Da-Biggest-Seal/BOARD-mic/mic.kicad_pcb

## KiCad design mic.kicad_pcb (2026-08-21)

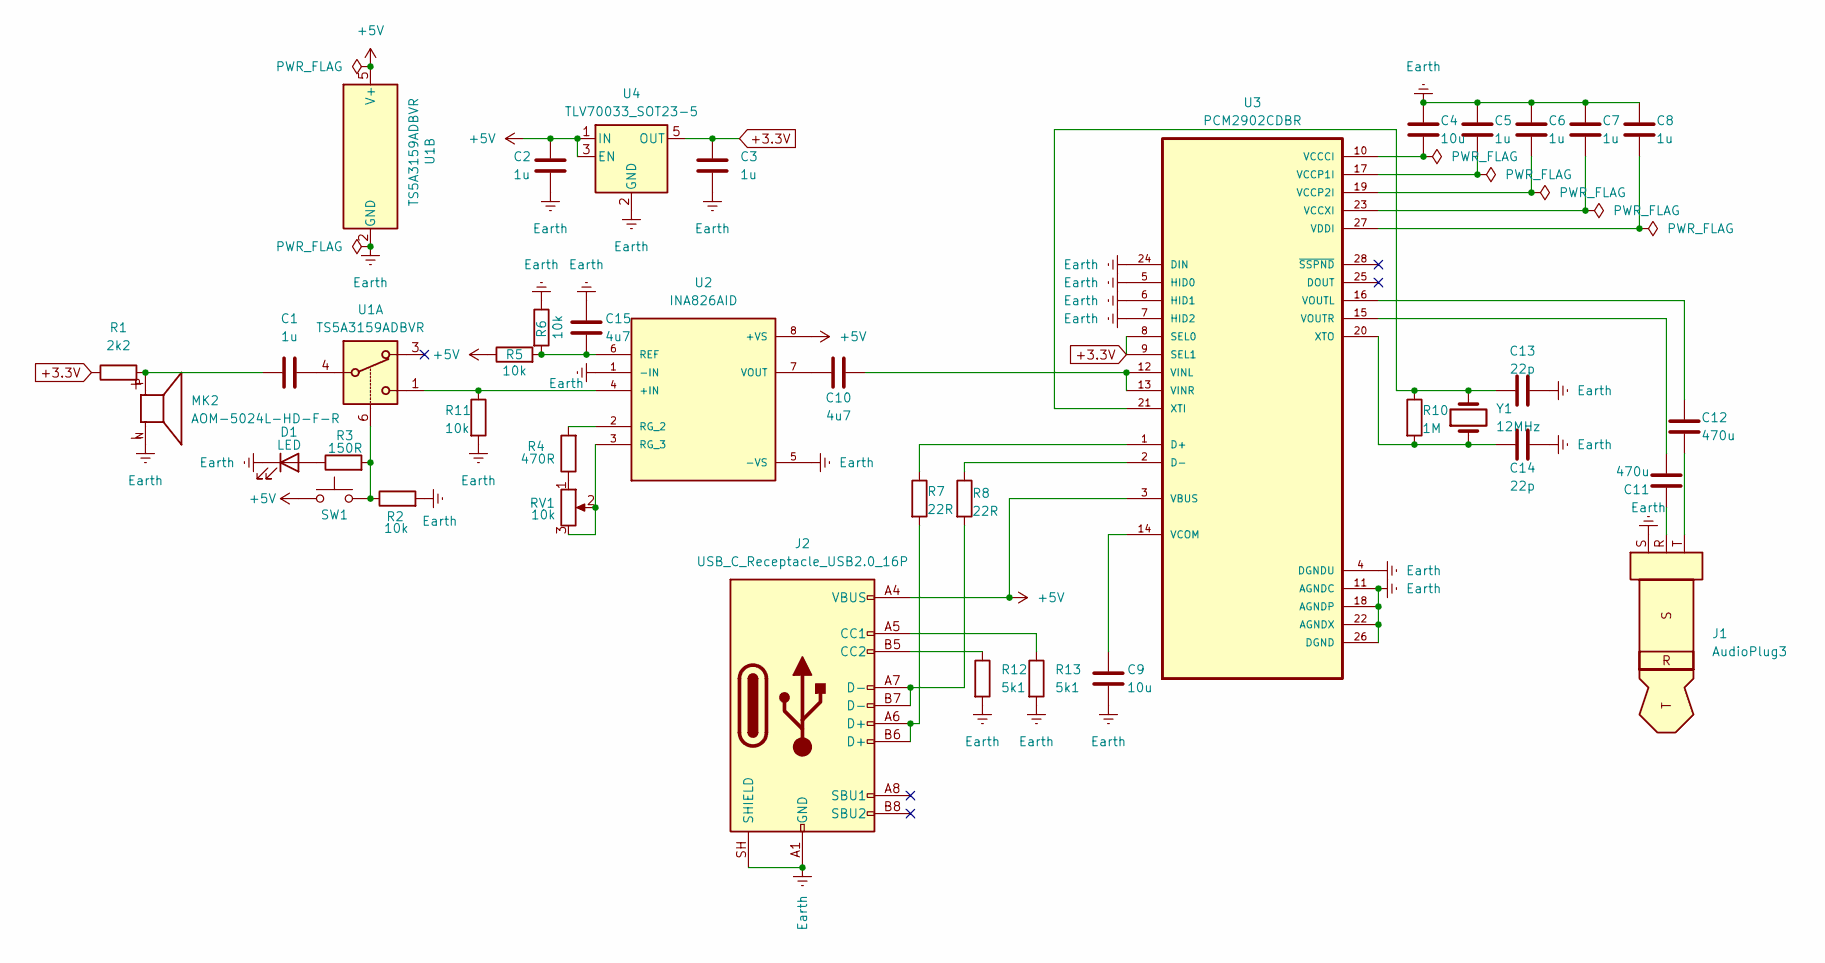
[picture p1: schematic mic.kicad_sch]

Parts:
C1, C2, C3, C5, C6, C7, C8: 1u; C_Disc_D3.4mm_W2.1mm_P2.50mm
C4, C9: 10u; C_Disc_D3.4mm_W2.1mm_P2.50mm
C10, C15: 4u7; C_Disc_D3.4mm_W2.1mm_P2.50mm
C11, C12: 470u; CP_Radial_D8.0mm_P3.50mm
C13, C14: 22p; C_Disc_D3.4mm_W2.1mm_P2.50mm
D1: LED; LED_D1.8mm_W1.8mm_H2.4mm_Horizontal_O1.27mm_Z1.6mm
J1: AudioPlug3; Jack_3.5mm_QingPu_WQP-PJ398SM_Vertical_CircularHoles; LCSC C22355828
J2: USB_C_Receptacle_USB2.0_16P; USB_C_Receptacle_G-Switch_GT-USB-7051x
MK2: AOM-5024L-HD-F-R; MIC_AOM-5024L-HD-F-R; PARTREV A
R1: 2k2; R_Axial_DIN0204_L3.6mm_D1.6mm_P2.54mm_Vertical
R2, R5, R6, R11: 10k; R_Axial_DIN0204_L3.6mm_D1.6mm_P2.54mm_Vertical
R3: 150R; R_Axial_DIN0204_L3.6mm_D1.6mm_P2.54mm_Vertical
R4: 470R; R_Axial_DIN0204_L3.6mm_D1.6mm_P2.54mm_Vertical
R7, R8: 22R; R_Axial_DIN0204_L3.6mm_D1.6mm_P2.54mm_Vertical
R10: 1M; R_Axial_DIN0204_L3.6mm_D1.6mm_P2.54mm_Vertical
R12, R13: 5k1; R_Axial_DIN0204_L3.6mm_D1.6mm_P2.54mm_Vertical
RV1: 10k; Potentiometer_Alps_RK097_Single_Horizontal
SW1: SW_Push; SW_Tactile_SPST_Angled_PTS645Vx58-2LFS
U1: TS5A3159ADBVR; SOT-23-6
U2: INA826AID; SOIC127P599X175-8N; PARTREV G; DigiKey_Part_Number 296-33294-5-ND
U3: PCM2902CDBR; SOP65P780X200-28N; DigiKey_Part_Number 2156-PCM2902CDBR-ND
U4: TLV70033_SOT23-5; SOT-23-5
Y1: 12MHz; Crystal_C26-LF_D2.1mm_L6.5mm_Vertical

Connections:
+3.3V: C3.1, R1.1, U3.8 (SEL0), U3.9 (SEL1), U4.5 (OUT)
+5V: C2.2, J2.A4 (VBUS), J2.A9 (VBUS), J2.B4 (VBUS), J2.B9 (VBUS), R5.1, SW1.1, U1.5 (V+), U2.8 (+VS), U3.3 (VBUS), U4.1 (IN), U4.3 (EN)
Earth: C2.1, C3.2, C4.1, C5.1, C6.1, C7.1, C8.1, C9.2, C13.2, C14.2, C15.1, D1.1 (K), J1.S, J2.A1 (GND), J2.A12 (GND), J2.B1 (GND), J2.B12 (GND), J2.SH (SHIELD), MK2.N, R2.2, R6.1, R11.2, R12.2, R13.2, U1.2 (GND), U2.1 (-IN), U2.5 (-VS), U3.4 (DGNDU), U3.5 (HID0), U3.6 (HID1), U3.7 (HID2), U3.11 (AGNDC), U3.18 (AGNDP), U3.22 (AGNDX), U3.24 (DIN), U3.26 (DGND), U4.2 (GND)
unnamed: C1.1, MK2.P, R1.2
unnamed: C1.2, U1.4
unnamed: C11.1, J1.R
unnamed: C12.2, J1.T
unnamed: D1.2 (A), R3.1
unnamed: J2.A5 (CC1), R13.1
unnamed: J2.B5 (CC2), R12.1
unnamed: J2.A6 (D+), J2.B6 (D+), R7.2
unnamed: J2.A7 (D-), J2.B7 (D-), R8.2
unnamed: R2.1, R3.2, SW1.2, U1.6
unnamed: R4.1, RV1.1
unnamed: R11.1, U1.1, U2.4 (+IN)
unnamed: C15.2, R5.2, R6.2, U2.6 (REF)
unnamed: R4.2, U2.2 (RG_2)
unnamed: RV1.2, RV1.3, U2.3 (RG_3)
unnamed: C10.2, U2.7 (VOUT)
unnamed: R7.1, U3.1 (D+)
unnamed: R8.1, U3.2 (D-)
unnamed: C4.2, U3.10 (VCCCI)
unnamed: C5.2, U3.17 (VCCP1I)
unnamed: C6.2, U3.19 (VCCP2I)
unnamed: C7.2, U3.23 (VCCXI)
unnamed: C9.1, U3.14 (VCOM)
unnamed: C8.2, U3.27 (VDDI)
unnamed: C10.1, U3.12 (VINL), U3.13 (VINR)
unnamed: C12.1, U3.16 (VOUTL)
unnamed: C11.2, U3.15 (VOUTR)
unnamed: C13.1, R10.1, U3.21 (XTI), Y1.2
unnamed: C14.1, R10.2, U3.20 (XTO), Y1.1

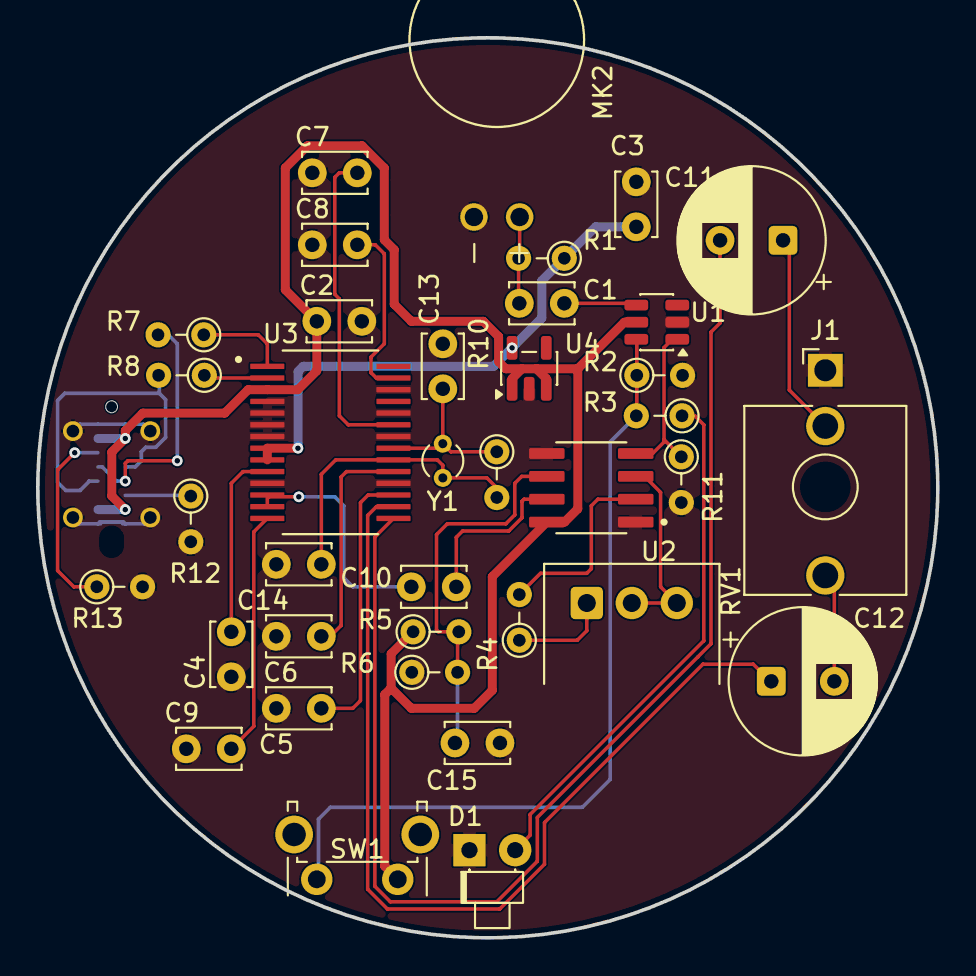
[picture p2: board mic.kicad_pcb from above]

Board: 2 copper layers, 50.0 x 50.0 mm, 38 parts (1 on the bottom side), 32 nets.
