Da-Biggest-Seal/BOARD-mic/(commit log)

2026-08-15 board upload from local
    [mic.kicad_pcb, mic.kicad_sch]
2026-08-15 v1 board layout
    [mic.kicad_pcb, mic.kicad_sch]
2026-08-15 alt board version finished
    [mic.kicad_pcb, mic.kicad_sch]
2026-08-15 some fixes, will need help
    [mic.kicad_pcb]
2026-08-21 some fixes
    [mic.kicad_pcb, mic.kicad_sch]
2026-08-21 alt_1 V1
    [mic.kicad_pcb, mic.kicad_sch]
